wagiminator/ATtiny13-TinyTouchLight/documentation/TinyTouchLight_pic1.jpg

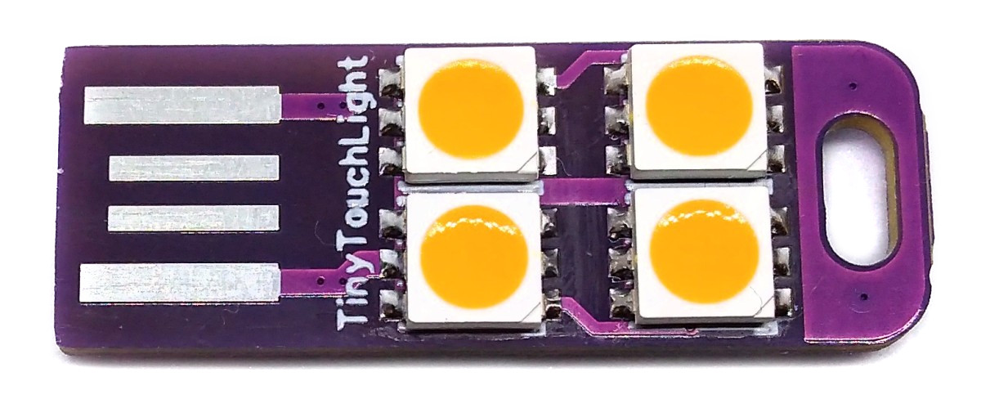
documentation/TinyTouchLight_pic1.jpg
