wagiminator/ATtiny13-TinyTouchLight/hardware/TinyTouchLight_BOM.tsv

ID | Name | Designator | Footprint | Quantity | Manufacturer Part | Manufacturer | Supplier | Supplier Part | Price
1 | 100n | C1 | C_0805 | 1 | CC0805KRX7R9BB104 | YAGEO | LCSC | C49678 | 0.004
2 | 47u | C2 | C_0805 | 1 | C0805X5R476M100NT | SANYEAR | LCSC | C466799 | 0.102
3 | 5050 | LED1,LED2,LED3,LED4 | LED_5050 | 4 | 61-238/GBC-YX2Y2M/ET | Everlight Elec | LCSC | C431970 | 0.231
4 | AO3400 | Q1 | SOT-23-3_W | 1 | AO3400 | KEXIN | LCSC | C382311 | 0.057
5 | 39R | R1,R2,R3,R4 | 0805 | 4 | 0805W8J0390T5E | UniOhm | LCSC | C25311 | 0.002
6 | 47k | R5 | 0805 | 1 | 0805W8F4702T5E | UniOhm | LCSC | C17713 | 0.002
7 | 1k | R6 | 0805 | 1 | 0805W8F1001T5E | UniOhm | LCSC | C17513 | 0.002
8 | 10k | R7 | 0805 | 1 | 0805W8F1002T5E | UniOhm | LCSC | C17414 | 0.002
9 | ATtiny13A | U1 | SOP-8_150MIL | 1 | ATTINY13A-SSU | MICROCHIP | LCSC | C14075 | 1.648
10 | USB PCB | USB | USB-A-PCB | 1 | USB-05 | SOFNG | LCSC | C112454 | 0.086
