wagiminator/ATtiny13-TinyTouchLight/hardware/TinyTouchLight_schematic.pdf

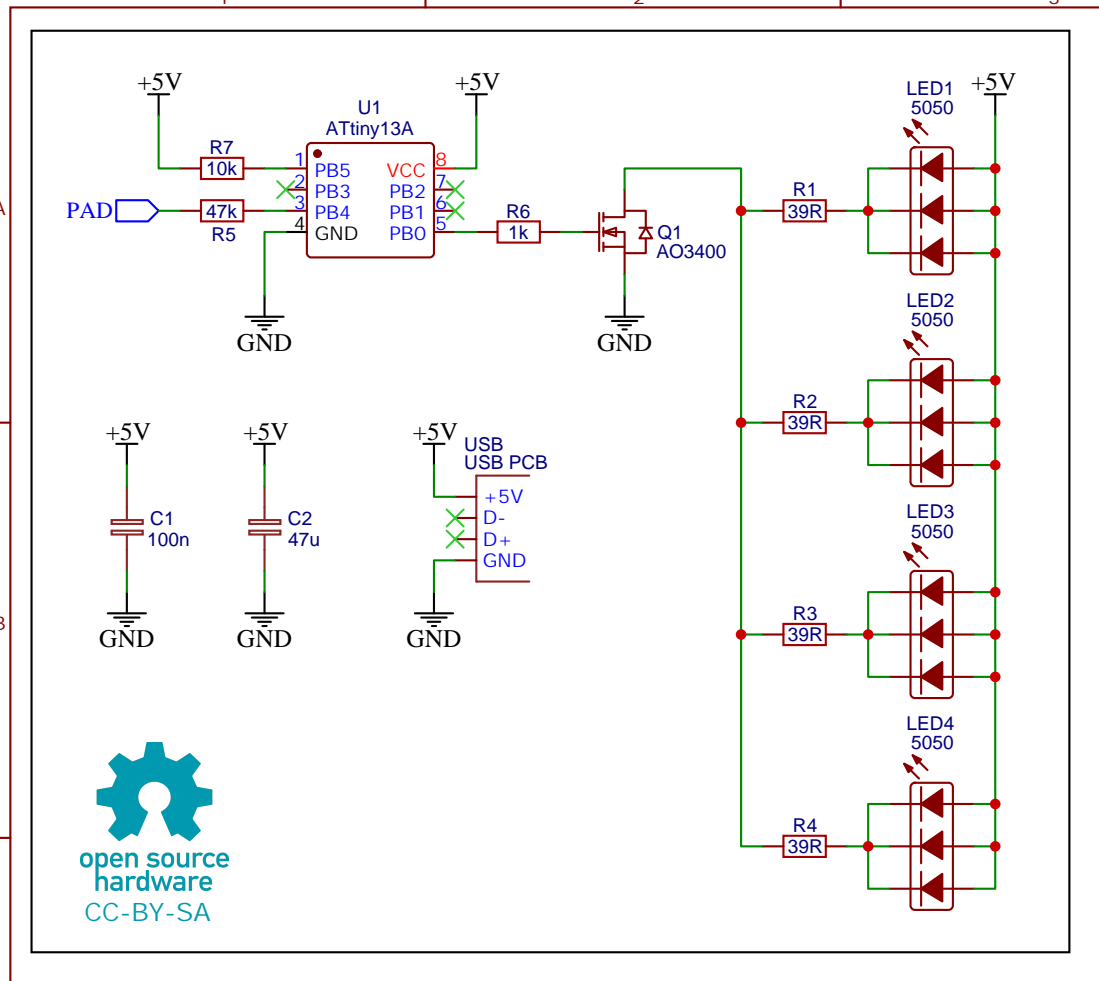
[picture p11: page 1]

Drawn By: Stefan Wagner
