wagiminator/ATtiny13-TinyTouchLight/documentation/TinyTouchLight_wiring.png

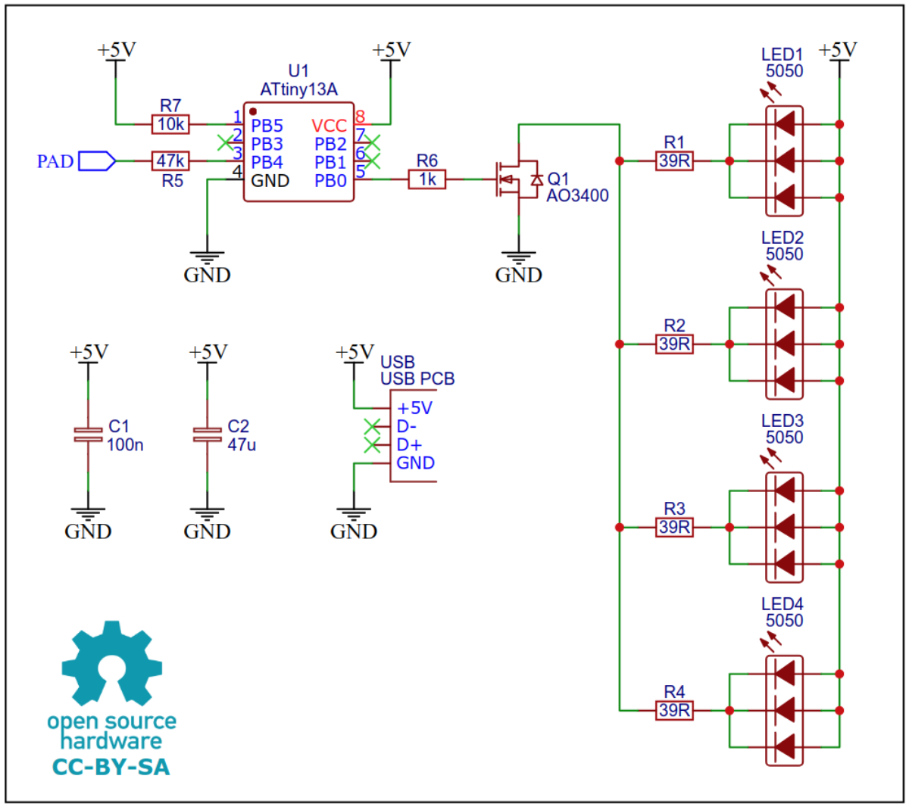
documentation/TinyTouchLight_wiring.png
